carlosgj/FRC-LED-Strip-Driver/Nonaddressable Controller.SLDASM

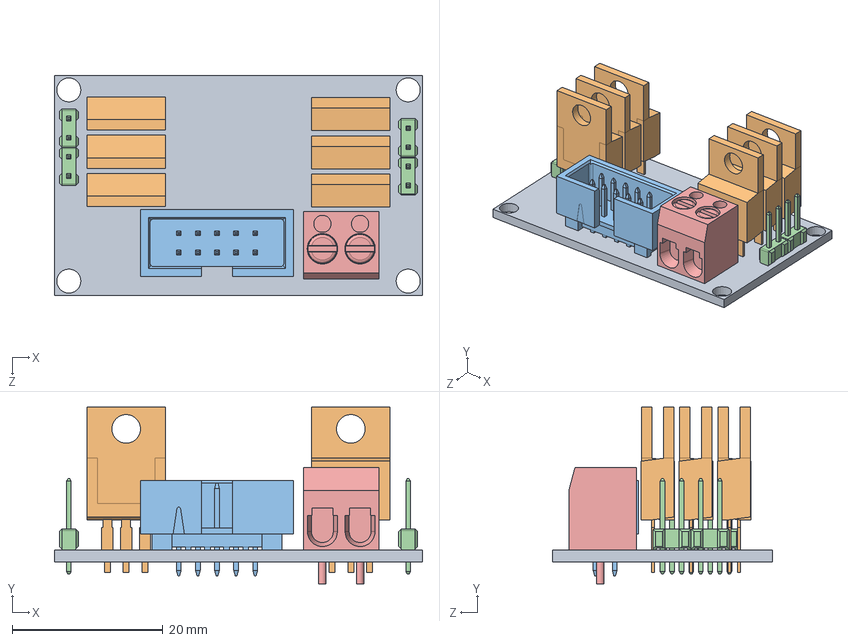
[picture p1: CAD file, 2018-03-16]
Nonaddressable Controller.SLDASM
48.9 x 23.5 x 29.2 mm
Nonaddressable Controller PCB
TO-220 x 6
Pin Header 2x1 TH Pitch 2.54mm x 4
