carlosgj/FRC-LED-Strip-Driver/Nonaddressable Controller PCB.SLDPRT

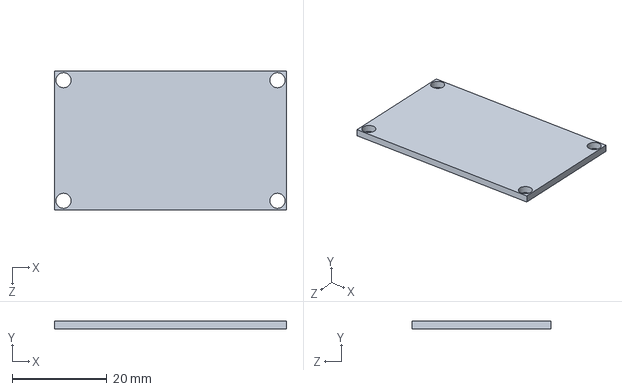
[picture p2: CAD file, 2018-03-16]
Nonaddressable Controller PCB.SLDPRT
48.9 x 1.59 x 29.2 mm
