carlosgj/FRC-LED-Strip-Driver/TO-220.SLDPRT

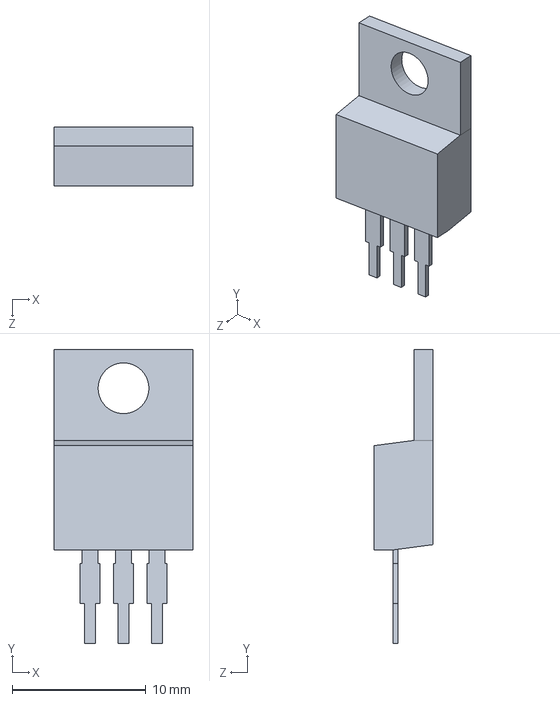
[picture p3: CAD file, 2018-03-16]
TO-220.SLDPRT
10.4 x 22.0 x 4.40 mm
