carlosgj/FRC-LED-Strip-Driver/237-102.SLDPRT

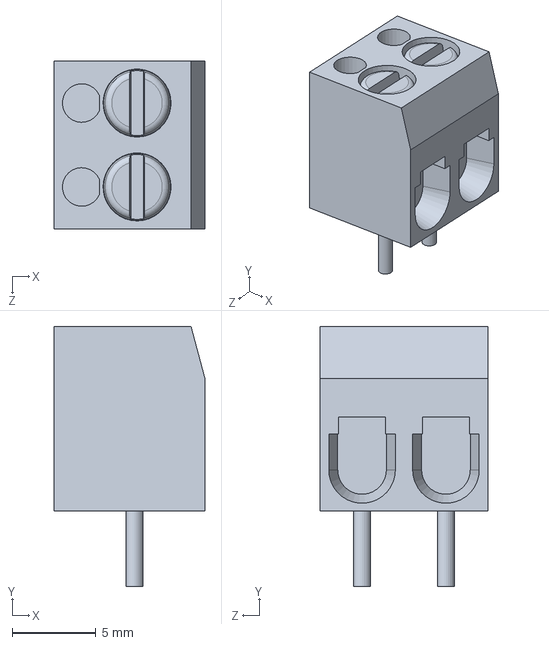
[picture p4: CAD file, 2018-03-16]
237-102.SLDPRT
9.00 x 15.5 x 10.0 mm
