carlosgj/FRC-LED-Strip-Driver/Nonaddressable Controller Mount.SLDPRT

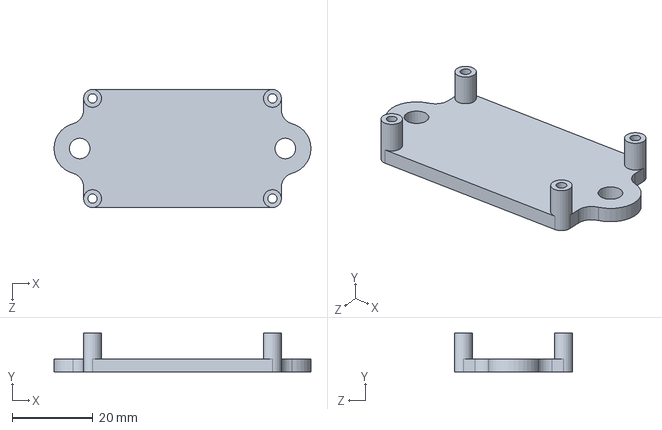
[picture p5: CAD file, 2018-03-16]
Nonaddressable Controller Mount.SLDPRT
63.5 x 9.53 x 29.2 mm
