carlosgj/FRC-LED-Strip-Driver/Pin Header 2x1 TH Pitch 2.54mm.SLDPRT

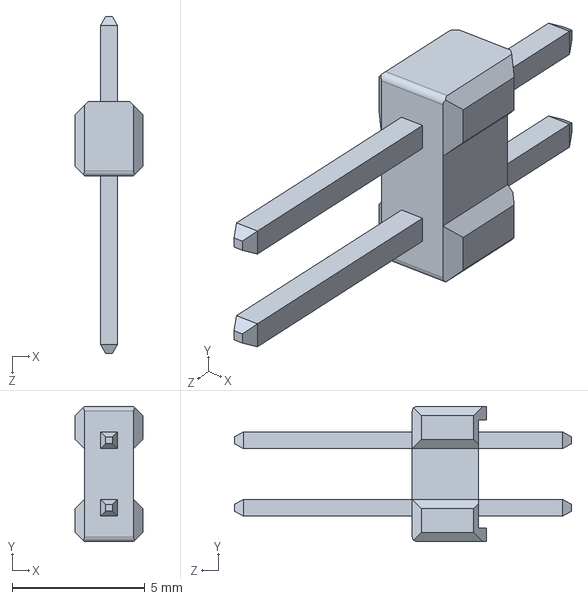
[picture p6: CAD file, 2018-03-16]
Pin Header 2x1 TH Pitch 2.54mm.SLDPRT
2.54 x 5.08 x 12.7 mm
