carlosgj/FRC-LED-Strip-Driver/702461001.SLDPRT

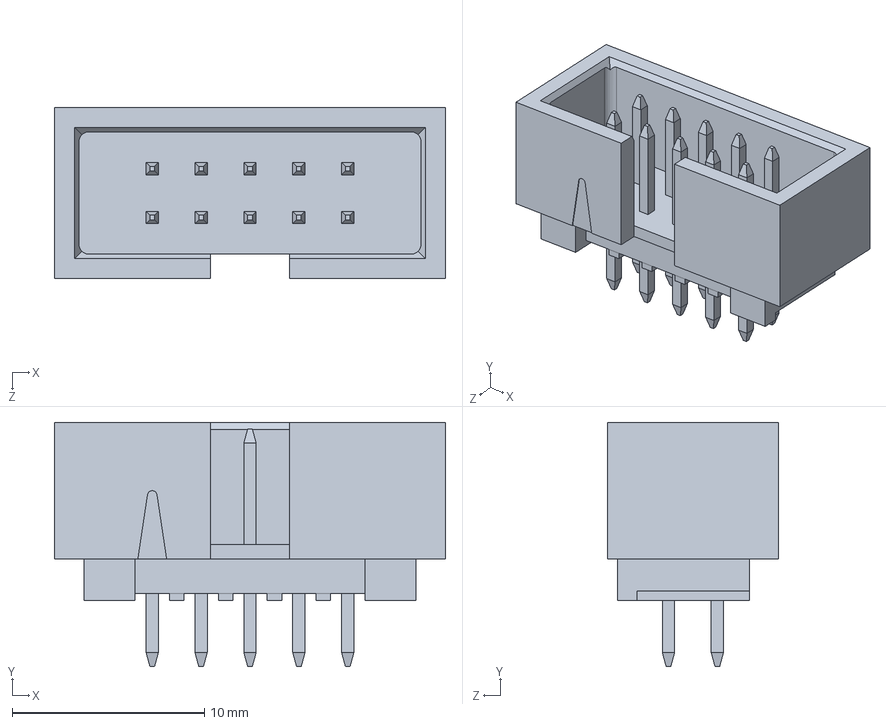
[picture p7: CAD file, 2018-03-16]
702461001.SLDPRT
20.3 x 12.7 x 8.89 mm
