carlosgj/FRC-LED-Strip-Driver/(list of files, cad)

Other CAD files:
LEDStripCtrlr.X/dist/default/production/LEDStripCtrlr.X.production.obj
NonaddressableController.X/dist/Sim/production/NonaddressableController.X.production.obj
Nonaddressable Controller Mount.IGS
