carlosgj/FRC-LED-Strip-Driver/Controller.brd

## EAGLE design Controller.brd (2019-10-08)

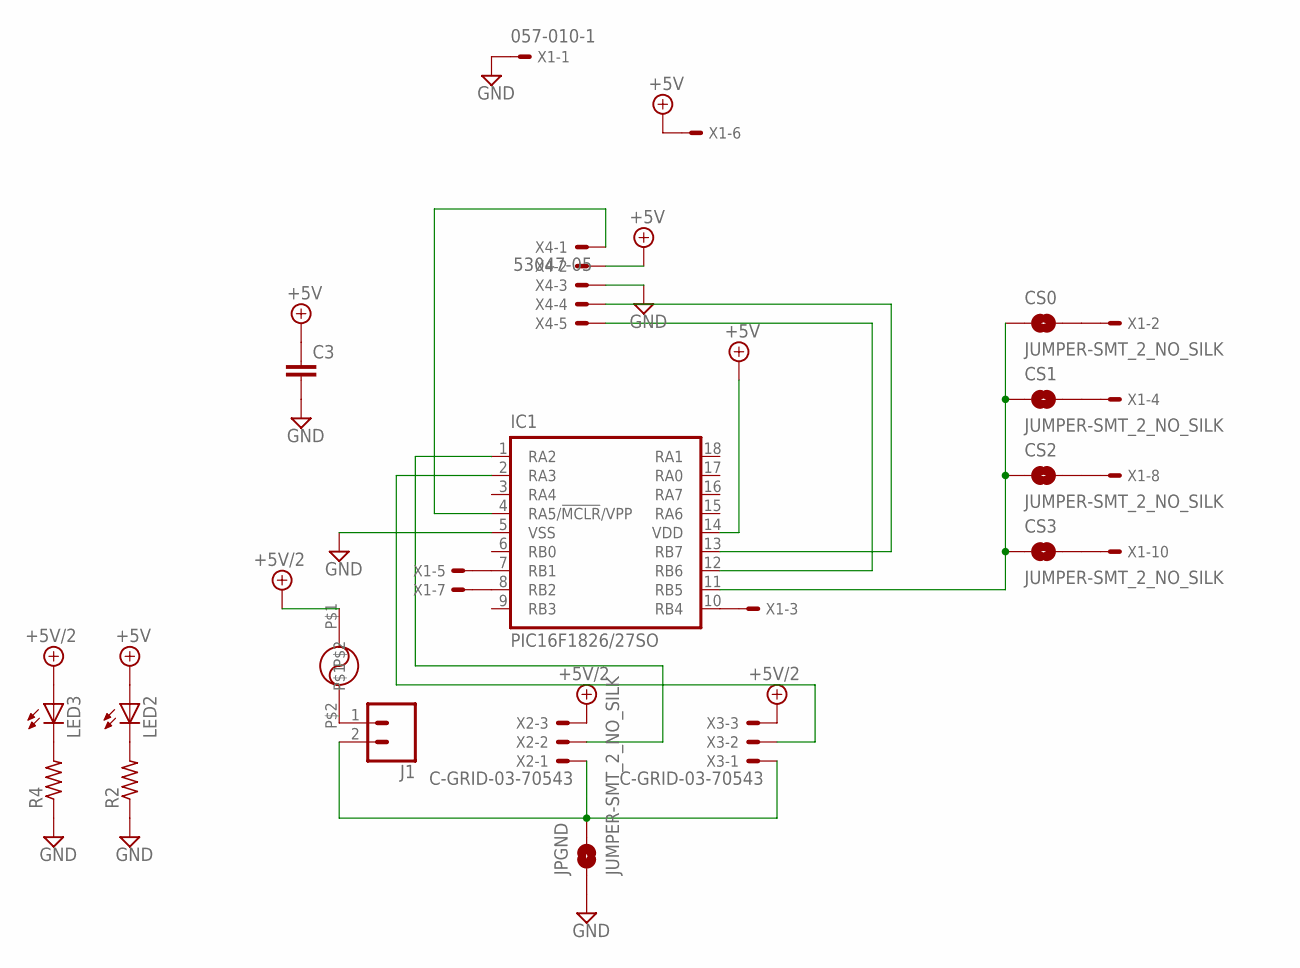
[picture p8: schematic Controller.sch]

Parts:
C3: C-EUC1206; C1206
CS0, CS1, CS2, CS3: JUMPER-SMT_2_NO_SILK; SMT-JUMPER_2_NO_SILK
IC1: PIC16F1826/27SO; SO-18W
J1: CONN_023.5MM; SCREWTERMINAL-3.5MM-2
JPGND: JUMPER-SMT_2_NO_SILK; SMT-JUMPER_2_NO_SILK
LED2, LED3: LEDCHIPLED_1206; CHIPLED_1206
R2, R4: R-US_R1206; R1206
U$3: 0034.6081; MSF250
X1: 057-010-1
X2, X3: C-GRID-03-70543; 70543-03
X4: 53047-05

Connections:
+5V: C3.1, IC1.14 (VDD), LED2.A, X1.6, X4.2
+5V/2: LED3.A, U$3.P$1, X2.3, X3.3
GND: C3.2, IC1.5 (VSS), JPGND.1, R2.1, R4.1, X1.1, X4.3
unnamed: IC1.10 (RB4), X1.3
unnamed: IC1.7 (RB1), X1.5
unnamed: IC1.8 (RB2), X1.7
unnamed: CS0.1, CS1.1, CS2.1, CS3.1, IC1.11 (RB5)
unnamed: CS0.2, X1.2
unnamed: CS1.2, X1.4
unnamed: CS2.2, X1.8
unnamed: CS3.2, X1.10
unnamed: J1.1, U$3.P$2
unnamed: LED3.C, R4.2
unnamed: J1.2, JPGND.2, X2.1, X3.1
unnamed: IC1.1 (RA2), X2.2
unnamed: IC1.2 (RA3), X3.2
unnamed: IC1.4 (RA5/!MCLR!/VPP), X4.1
unnamed: IC1.13 (RB7), X4.4
unnamed: IC1.12 (RB6), X4.5
unnamed: LED2.C, R2.2

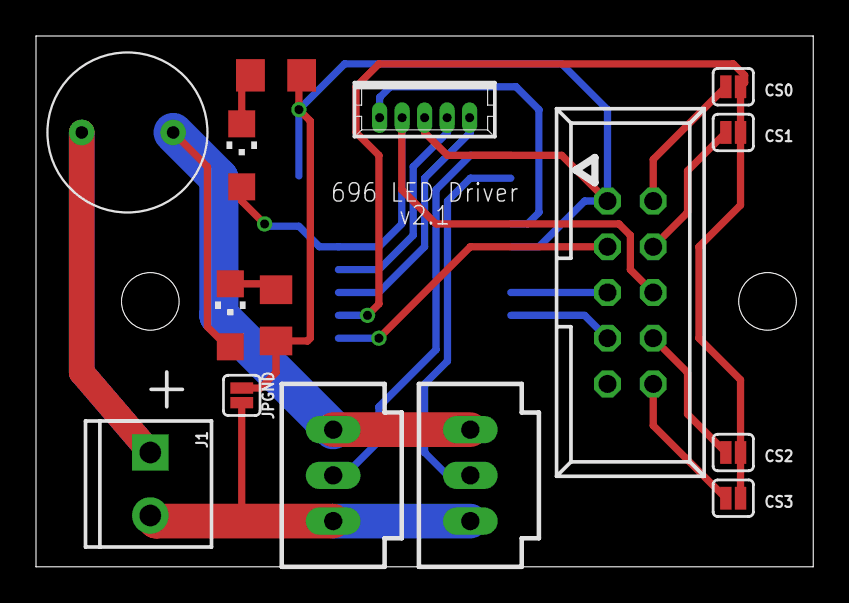
[picture p9: board Controller.brd from above]

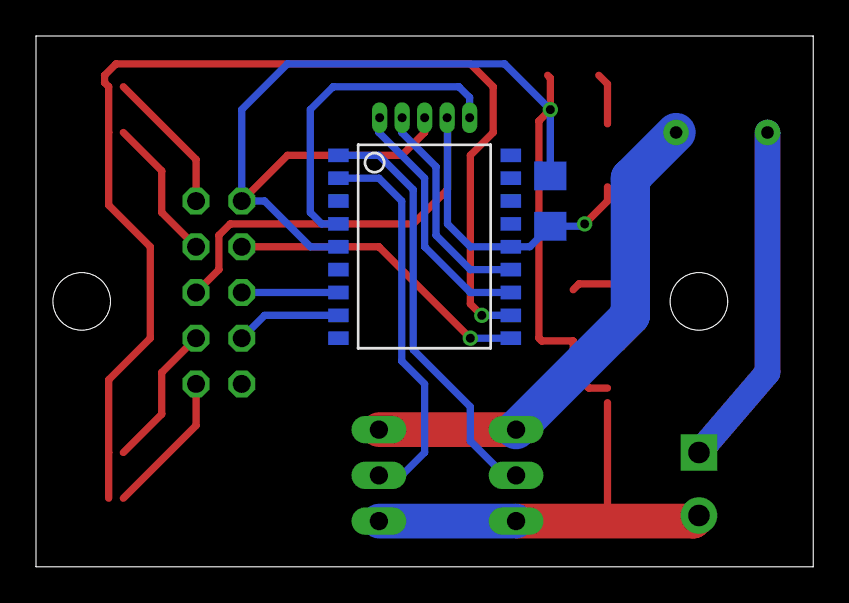
[picture p10: board Controller.brd from below]

Board: 2 copper layers, 43.2 x 29.5 mm, 17 parts (2 on the bottom side), 20 nets.
