carlosgj/FRC-LED-Strip-Driver/Big Nonaddressable Controller.brd

## EAGLE design Big Nonaddressable Controller.brd (2018-09-01)

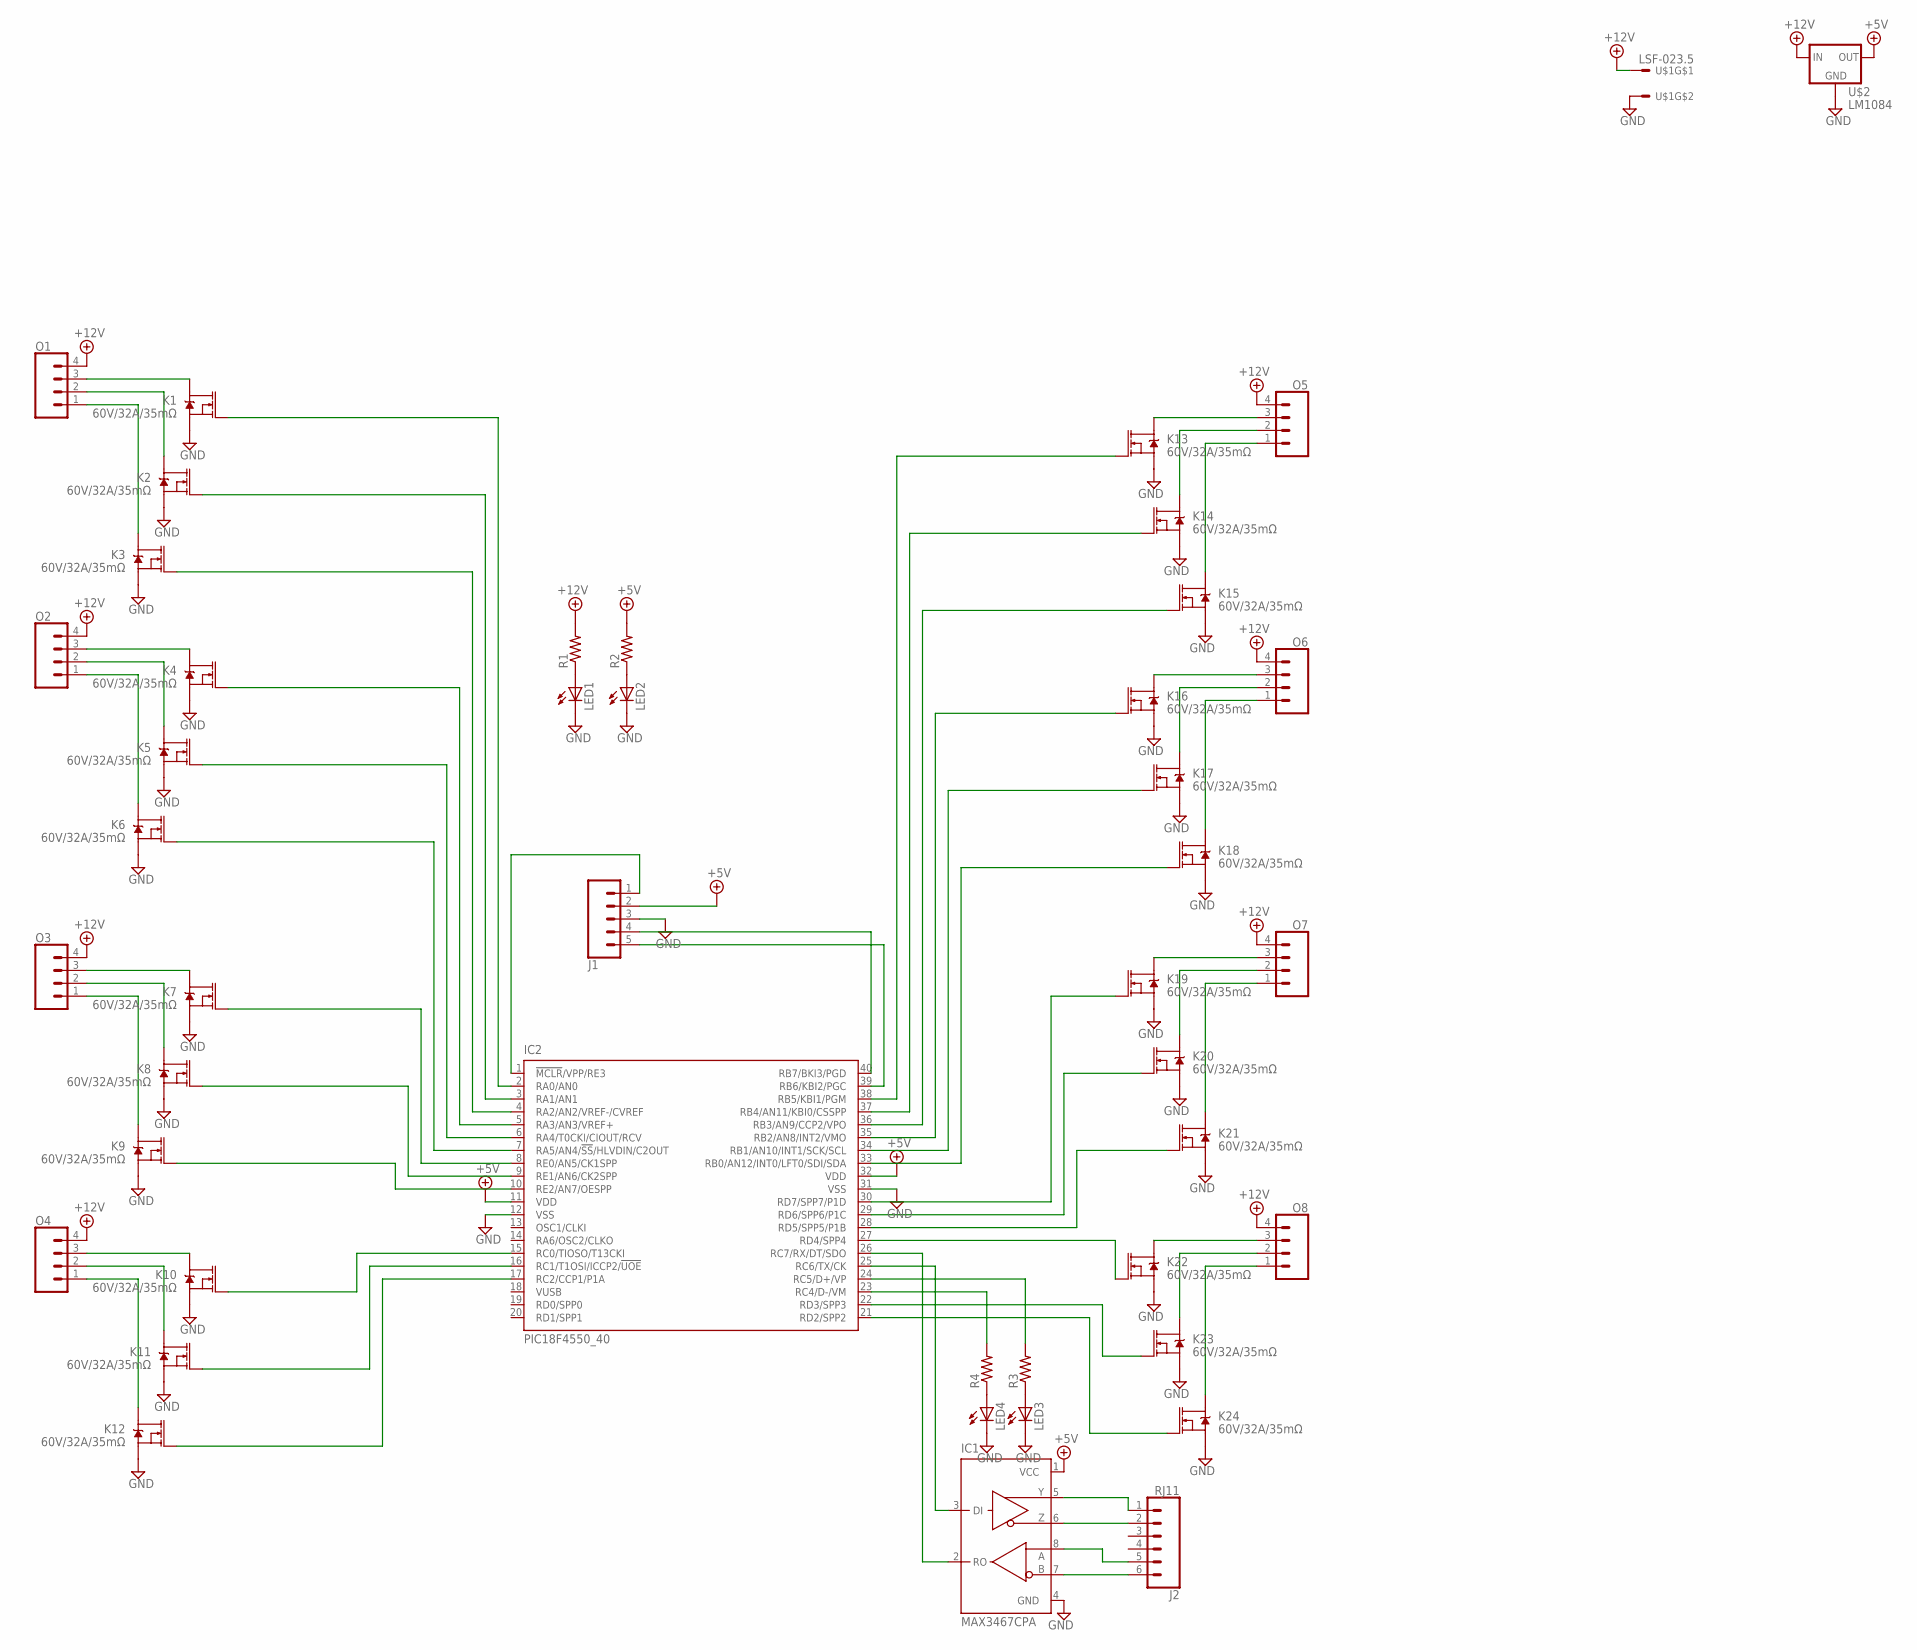
[picture p11: schematic Big Nonaddressable Controller.sch]

Parts:
IC1: MAX3467CPA; SO08
IC2: PIC18F4550_40; DIL40
J1: CONN_05; 1X05
J2: RJ11; RJ11-6
K1, K2, K3, K4, K5, K6, K7, K8, K9, K10, K11, K12, K13, K14, K15, K16, K17, K18, K19, K20, K21, K22, K23, K24: 60V/32A/35mΩ; TO220V
LED1, LED2, LED3, LED4: LED3MM
O1, O2, O3, O4, O5, O6, O7, O8: CONN_04; 1X04
R1, R2, R3, R4: R-US_0204/2V; 0204V
U$1: LSF-023.5; LSF-3.5
U$2: LM1084; D2PACK

Connections:
+5V: IC1.1 (VCC), IC2.11 (VDD), IC2.32 (VDD), J1.2, R2.2, U$2.2 (OUT)
+12V: O1.4, O2.4, O3.4, O4.4, O5.4, O6.4, O7.4, O8.4, R1.2, U$1.P$3, U$2.3 (IN)
GND: IC1.4 (GND), IC2.12 (VSS), IC2.31 (VSS), J1.3, K1.3 (S), K2.3 (S), K3.3 (S), K4.3 (S), K5.3 (S), K6.3 (S), K7.3 (S), K8.3 (S), K9.3 (S), K10.3 (S), K11.3 (S), K12.3 (S), K13.3 (S), K14.3 (S), K15.3 (S), K16.3 (S), K17.3 (S), K18.3 (S), K19.3 (S), K20.3 (S), K21.3 (S), K22.3 (S), K23.3 (S), K24.3 (S), LED1.K (C), LED2.K (C), LED3.K (C), LED4.K (C), U$1.P$4, U$2.1 (GND)
unnamed: IC2.40 (RB7/BKI3/PGD), J1.4
unnamed: IC2.39 (RB6/KBI2/PGC), J1.5
unnamed: IC1.2 (RO), IC2.26 (RC7/RX/DT/SDO)
unnamed: IC1.3 (DI), IC2.25 (RC6/TX/CK)
unnamed: K4.2 (D), O2.3
unnamed: K5.2 (D), O2.2
unnamed: K6.2 (D), O2.1
unnamed: IC2.2 (RA0/AN0), K1.1 (G)
unnamed: IC2.3 (RA1/AN1), K2.1 (G)
unnamed: IC2.4 (RA2/AN2/VREF-/CVREF), K3.1 (G)
unnamed: IC2.1 (!MCLR!/VPP/RE3), J1.1
unnamed: IC2.5 (RA3/AN3/VREF+), K4.1 (G)
unnamed: IC2.6 (RA4/T0CKI/CIOUT/RCV), K5.1 (G)
unnamed: IC2.7 (RA5/AN4/!SS!/HLVDIN/C2OUT), K6.1 (G)
unnamed: K7.2 (D), O3.3
unnamed: K8.2 (D), O3.2
unnamed: K9.2 (D), O3.1
unnamed: K10.2 (D), O4.3
unnamed: K11.2 (D), O4.2
unnamed: K12.2 (D), O4.1
unnamed: IC2.8 (RE0/AN5/CK1SPP), K7.1 (G)
unnamed: IC2.9 (RE1/AN6/CK2SPP), K8.1 (G)
unnamed: K1.2 (D), O1.3
unnamed: K2.2 (D), O1.2
unnamed: K3.2 (D), O1.1
unnamed: IC2.10 (RE2/AN7/OESPP), K9.1 (G)
unnamed: IC2.17 (RC2/CCP1/P1A), K12.1 (G)
unnamed: IC2.16 (RC1/T1OSI/ICCP2/!UOE), K11.1 (G)
unnamed: IC2.15 (RC0/TIOSO/T13CKI), K10.1 (G)
unnamed: K13.2 (D), O5.3
unnamed: K14.2 (D), O5.2
unnamed: K15.2 (D), O5.1
unnamed: IC2.38 (RB5/KBI1/PGM), K13.1 (G)
unnamed: IC2.37 (RB4/AN11/KBI0/CSSPP), K14.1 (G)
unnamed: IC2.36 (RB3/AN9/CCP2/VPO), K15.1 (G)
unnamed: K16.2 (D), O6.3
unnamed: K17.2 (D), O6.2
unnamed: K18.2 (D), O6.1
unnamed: IC2.35 (RB2/AN8/INT2/VMO), K16.1 (G)
unnamed: IC2.34 (RB1/AN10/INT1/SCK/SCL), K17.1 (G)
unnamed: IC2.33 (RB0/AN12/INT0/LFT0/SDI/SDA), K18.1 (G)
unnamed: K19.2 (D), O7.3
unnamed: K20.2 (D), O7.2
unnamed: K21.2 (D), O7.1
unnamed: K22.2 (D), O8.3
unnamed: K23.2 (D), O8.2
unnamed: K24.2 (D), O8.1
unnamed: IC2.30 (RD7/SPP7/P1D), K19.1 (G)
unnamed: IC2.29 (RD6/SPP6/P1C), K20.1 (G)
unnamed: IC2.28 (RD5/SPP5/P1B), K21.1 (G)
unnamed: IC2.27 (RD4/SPP4), K22.1 (G)
unnamed: IC2.22 (RD3/SPP3), K23.1 (G)
unnamed: IC2.21 (RD2/SPP2), K24.1 (G)
unnamed: IC1.7 (B), J2.6
unnamed: IC1.8 (A), J2.5
unnamed: IC1.5 (Y), J2.1
unnamed: IC1.6 (Z), J2.2
unnamed: LED1.A, R1.1
unnamed: LED2.A, R2.1
unnamed: LED3.A, R3.1
unnamed: LED4.A, R4.1
unnamed: IC2.24 (RC5/D+/VP), R3.2
unnamed: IC2.23 (RC4/D-/VM), R4.2

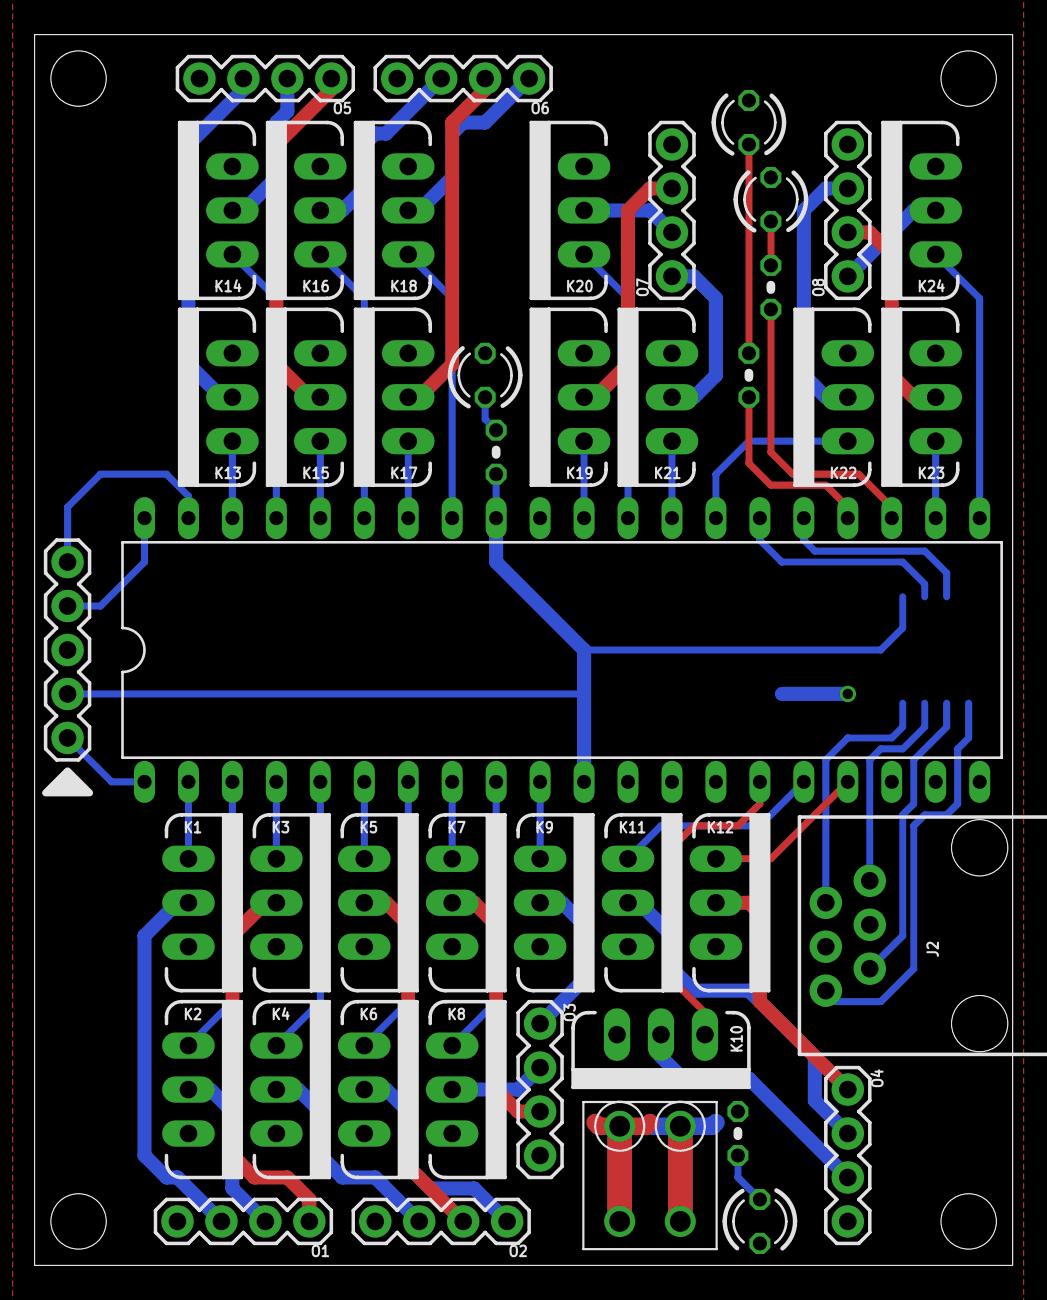
[picture p12: board Big Nonaddressable Controller.brd from above]

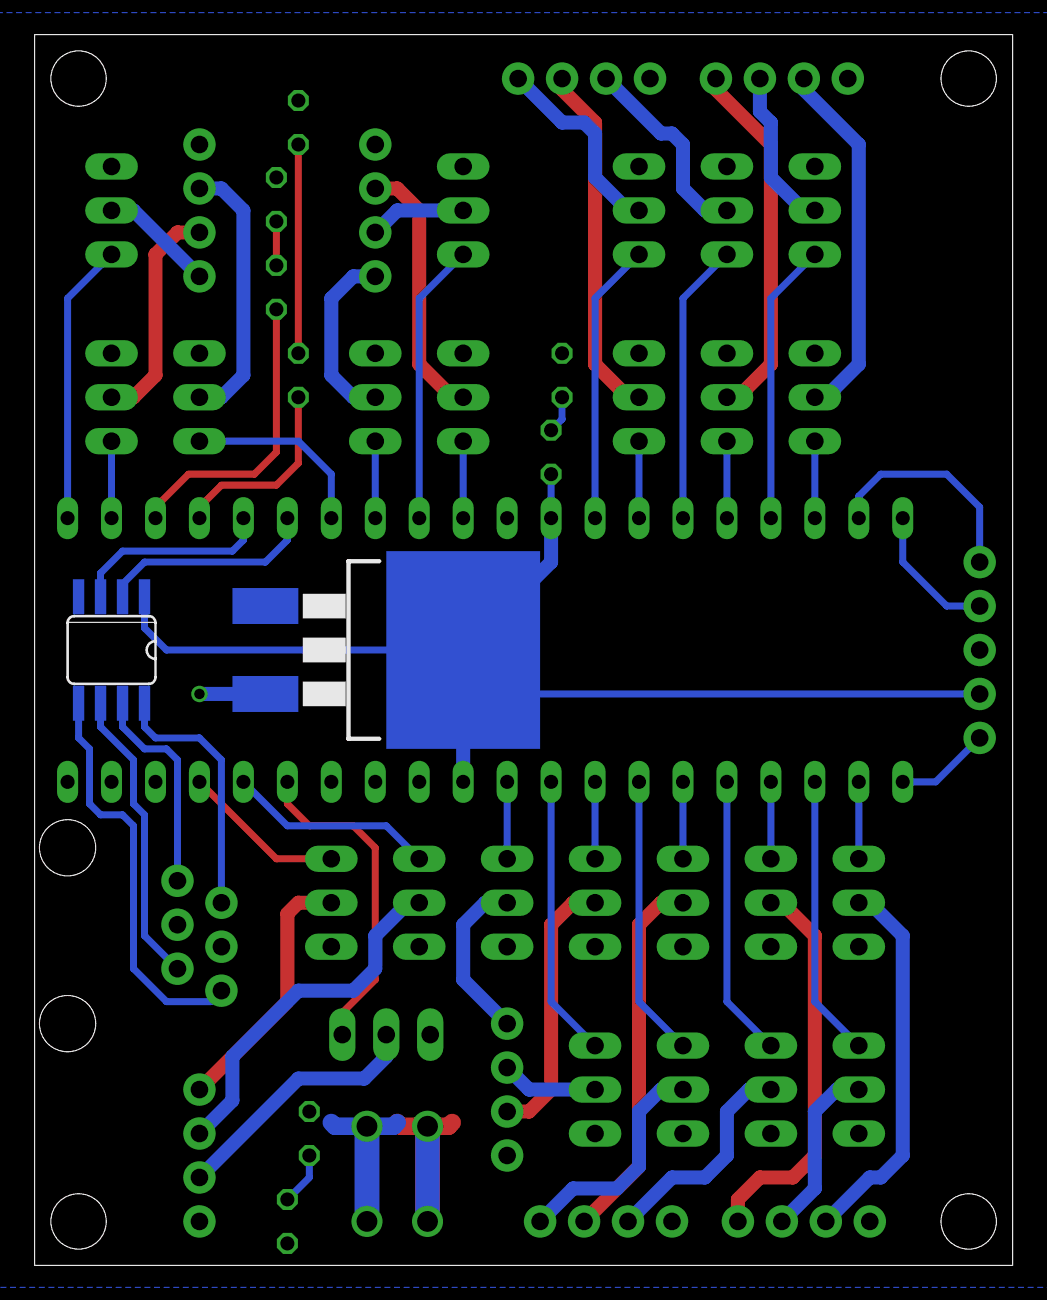
[picture p13: board Big Nonaddressable Controller.brd from below]

Board: 2 copper layers, 56.5 x 71.1 mm, 46 parts (2 on the bottom side), 66 nets.
