carlosgj/FRC-LED-Strip-Driver/Nonaddressable Controller.brd

## EAGLE design Nonaddressable Controller.brd (2018-01-20)

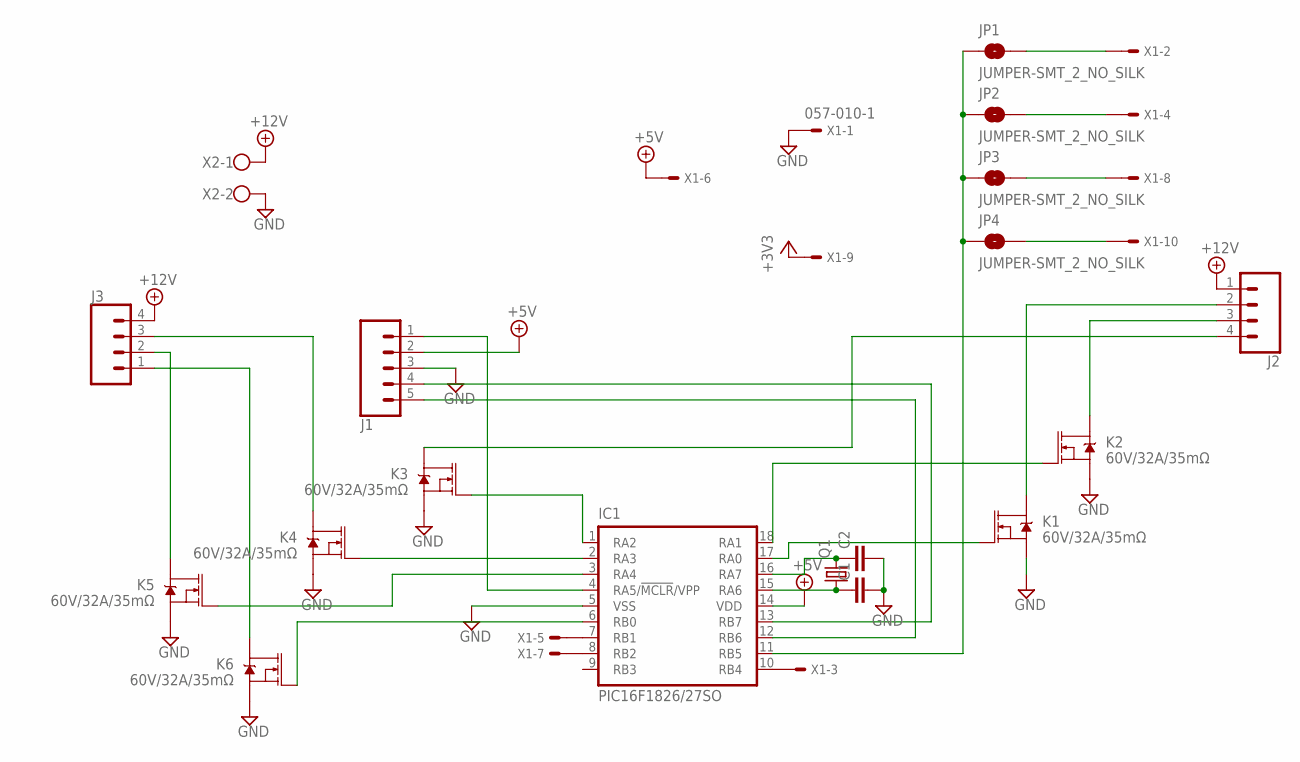
[picture p14: schematic Nonaddressable Controller.sch]

Parts:
C1, C2: C-EUC1206; C1206
IC1: PIC16F1826/27SO; SO-18W
J1: CONN_05; 1X05
J2, J3: CONN_04; 1X04
JP1, JP2, JP3, JP4: JUMPER-SMT_2_NO_SILK; SMT-JUMPER_2_NO_SILK
K1, K2, K3, K4, K5, K6: 60V/32A/35mΩ; TO220V
Q1: CRYSTALHC49S; HC49/S
X1: 057-010-1
X2: W237-102

Connections:
+3V3: X1.9
+5V: IC1.14 (VDD), J1.2, X1.6
+12V: J2.1, J3.4, X2.1
GND: C1.2, C2.2, IC1.5 (VSS), J1.3, K1.3 (S), K2.3 (S), K3.3 (S), K4.3 (S), K5.3 (S), K6.3 (S), X1.1, X2.2
unnamed: IC1.10 (RB4), X1.3
unnamed: IC1.7 (RB1), X1.5
unnamed: IC1.8 (RB2), X1.7
unnamed: JP1.2, X1.2
unnamed: JP2.2, X1.4
unnamed: JP3.2, X1.8
unnamed: JP4.2, X1.10
unnamed: IC1.11 (RB5), JP1.1, JP2.1, JP3.1, JP4.1
unnamed: C1.1, IC1.15 (RA6), Q1.1
unnamed: C2.1, IC1.16 (RA7), Q1.2
unnamed: IC1.4 (RA5/!MCLR!/VPP), J1.1
unnamed: IC1.13 (RB7), J1.4
unnamed: IC1.12 (RB6), J1.5
unnamed: IC1.17 (RA0), K1.1 (G)
unnamed: IC1.18 (RA1), K2.1 (G)
unnamed: IC1.1 (RA2), K3.1 (G)
unnamed: IC1.2 (RA3), K4.1 (G)
unnamed: IC1.3 (RA4), K5.1 (G)
unnamed: IC1.6 (RB0), K6.1 (G)
unnamed: J2.2, K1.2 (D)
unnamed: J2.3, K2.2 (D)
unnamed: J2.4, K3.2 (D)
unnamed: J3.3, K4.2 (D)
unnamed: J3.2, K5.2 (D)
unnamed: J3.1, K6.2 (D)

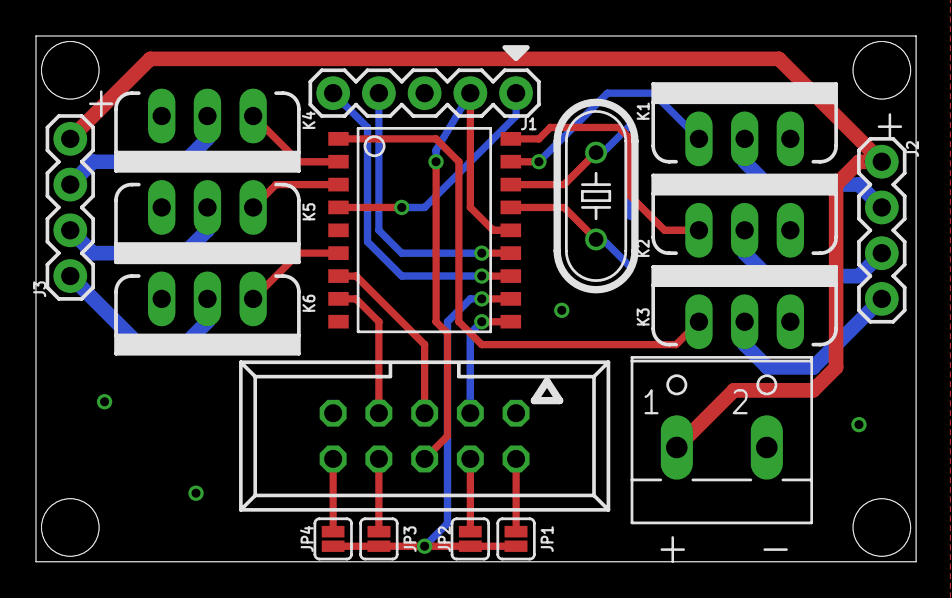
[picture p15: board Nonaddressable Controller.brd from above]

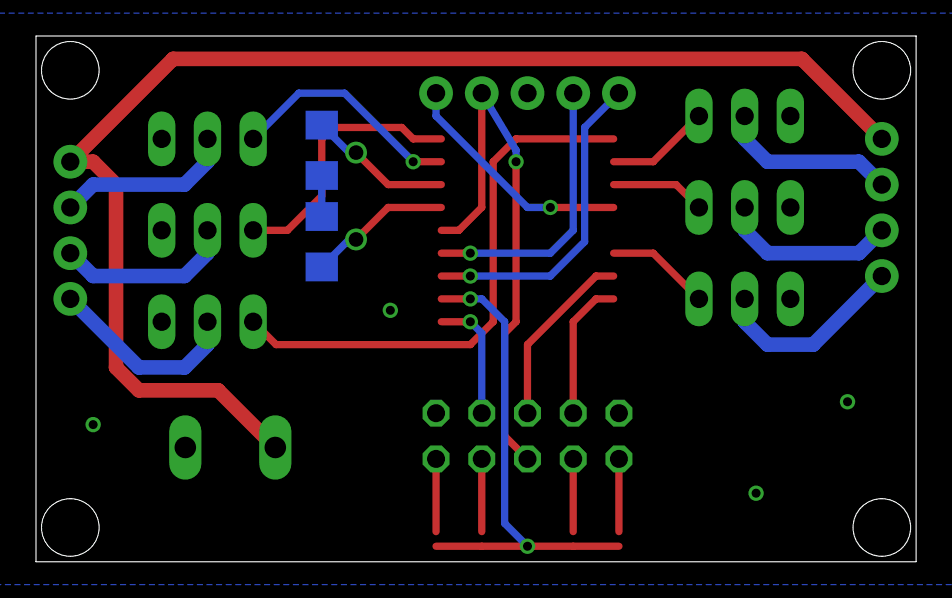
[picture p16: board Nonaddressable Controller.brd from below]

Board: 2 copper layers, 48.9 x 29.2 mm, 19 parts (2 on the bottom side), 28 nets.
