carlosgj/FRC-LED-Strip-Driver/Addressable-Controller.X/shared.h

#ifndef SHARED_H
#define	SHARED_H


//#define DEBUG

#ifdef DEBUG
#define THEPIN 0xD, 4
#else
#define THEPIN1 0xC, 2
#define THEPIN2 0xC, 3
#endif 

#define NUM_LEDS 45

#endif	/* XC_HEADER_TEMPLATE_H */
