carlosgj/FRC-LED-Strip-Driver/LEDStripCtrlr.X/pindefs.h

#ifndef PINDEFS_H
#define	PINDEFS_H

#include <xc.h> // include processor files - each processor file is guarded.  

#define CH_1_TRIS TRISAbits.TRISA2
#define CH_1_LAT LATAbits.LATA2

#define CH_2_TRIS TRISAbits.TRISA3
#define CH_2_LAT LATAbits.LATA3

#endif
