carlosgj/FRC-LED-Strip-Driver/(commit log)

2018-01-20 Added plain LED strip driver
    [Nonaddressable Controller.brd, Nonaddressable Controller.sch]
2018-01-31 Work on code for nonaddressable strip controller
    [Nonaddressable Controller.sch, NonaddressableController.X.production.obj]
2018-01-31 Should work
    [NonaddressableController.X.production.obj]
2018-02-05 Rainbow mode works
    [NonaddressableController.X.production.obj]
2018-03-16 Green heartbeat
    [237-102.SLDPRT, 702461001.SLDPRT, Nonaddressable Controller Mount.IGS, Nonaddressable Controller Mount.SLDPRT, Nonaddressable Controller PCB.SLDPRT, Nonaddressable Controller.SLDASM, NonaddressableController.X.production.obj, Pin Header 2x1 TH Pitch 2.54mm.SLDPRT]
2018-03-16 Added pattern spreadsheet
    [Patterns.xlsx]
2018-03-17 Use of crystal is buggy currently
    [main.c, main.h]
2018-03-30 Got SPI working
2018-03-30 Arduino SPI sender
2019-01-30 Updated design to include 5V power supply
    [Controller.brd, Controller.sch]
2019-02-04 Basic LED strip control works
2019-02-07 Implementing SPI communication
2019-02-24 Adding new patterns
    [Patterns.xlsx]
2019-10-08 Implementing patterns
    [Patterns.xlsx]
2019-10-08 Removing onboard voltage regulator
    [Controller.brd, Controller.sch]
2019-10-08 Implementing more patterns
    [Patterns.xlsx]
2019-10-09 Arduino SPI test code works with addressable controller
